UCSD-E4E/Wolf-Tracker/Final V4/Final V4/Step 9.JPG

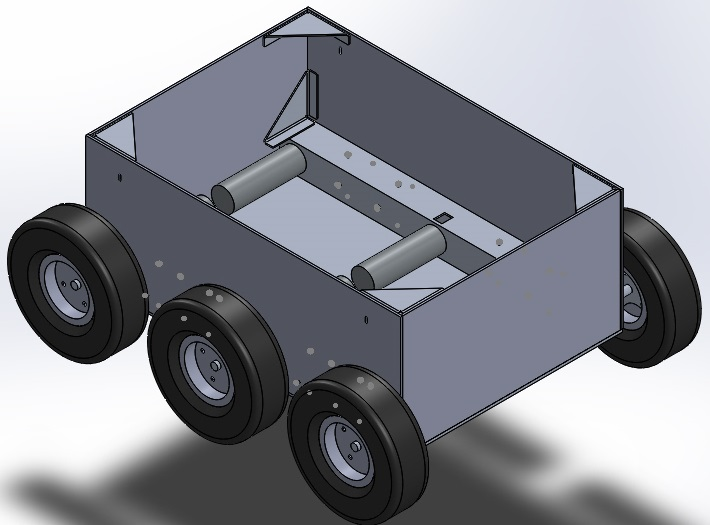
Final V4/Final V4/Step 9.JPG
