UCSD-E4E/Wolf-Tracker/Final V4/Final V4/Rover Documentation.docx

Engineers for Exploration

Terrestrial Vehicle

2013-2014

Rover Assembly Instructions

Legend/Reference Page

Picture | Description/Name

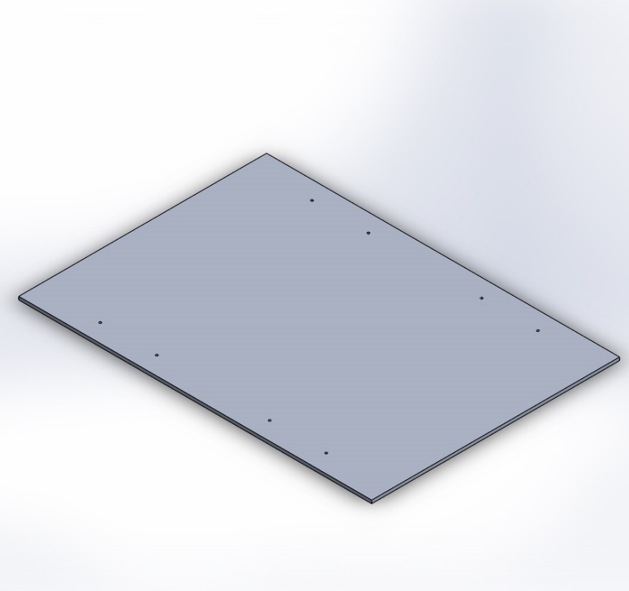
[picture p3: figure]

| Base Plate

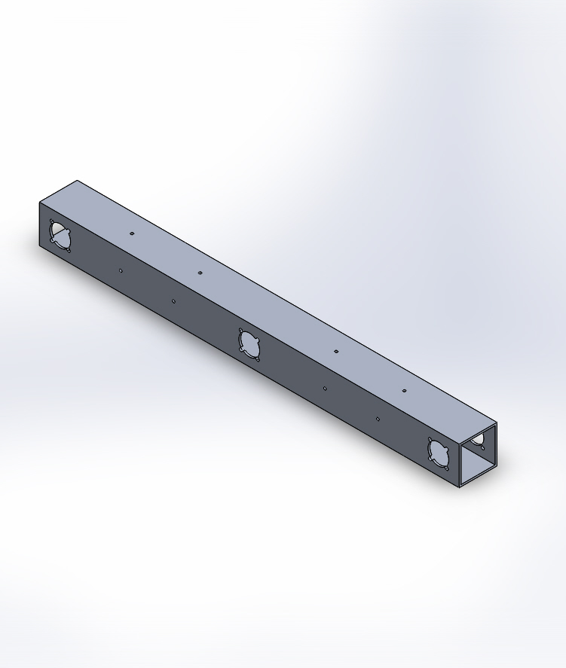
[picture p4: figure]

| Aluminum Bar

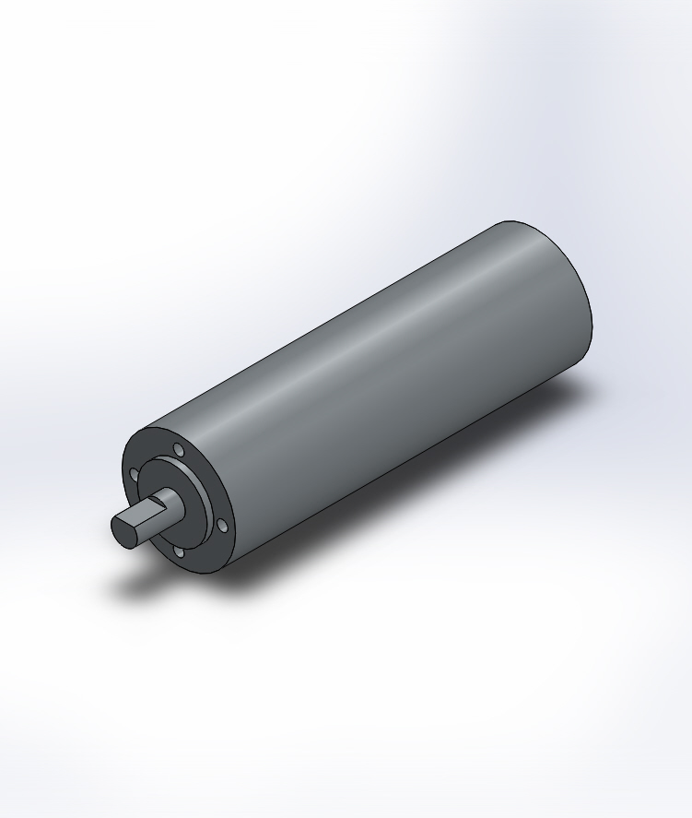
[picture p5: figure]

| Motors

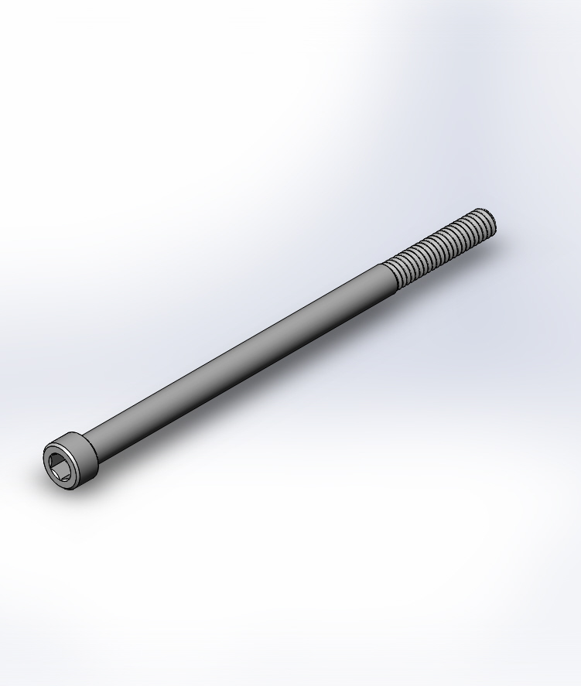
[picture p6: figure]

| 8-32 3.0” Long Screw

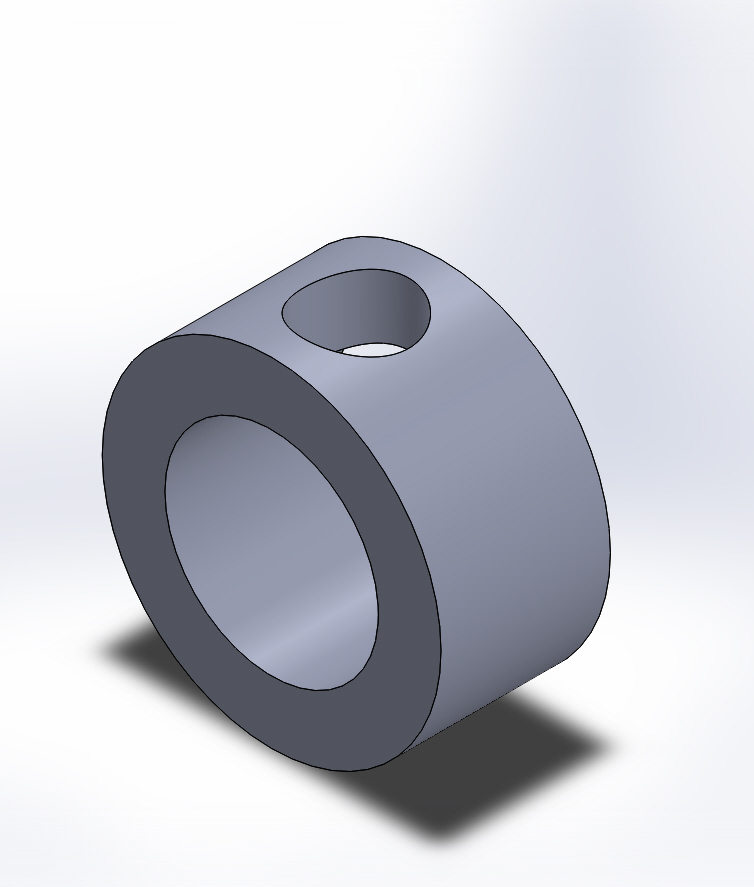
[picture p7: figure]

| Shaft Collar

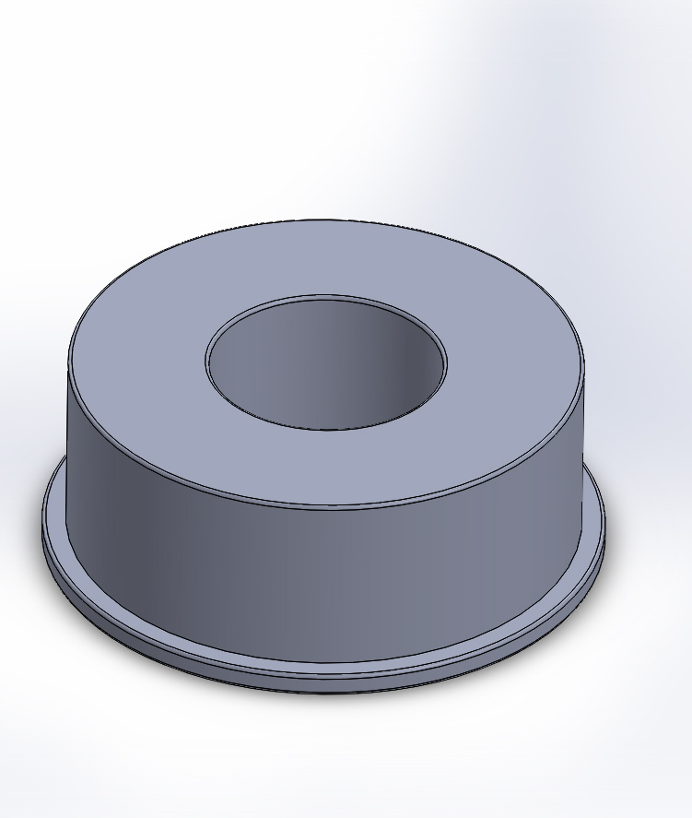
[picture p8: figure]

| Flanged Bearing

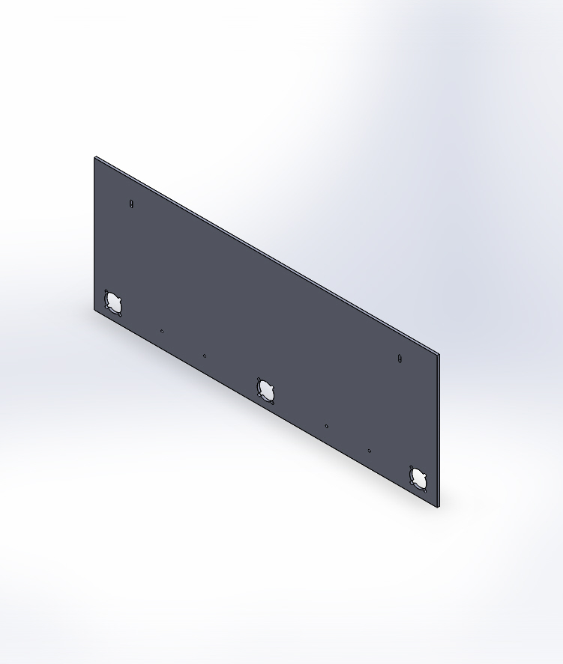
[picture p9: figure]

| Left/Right Side Plate

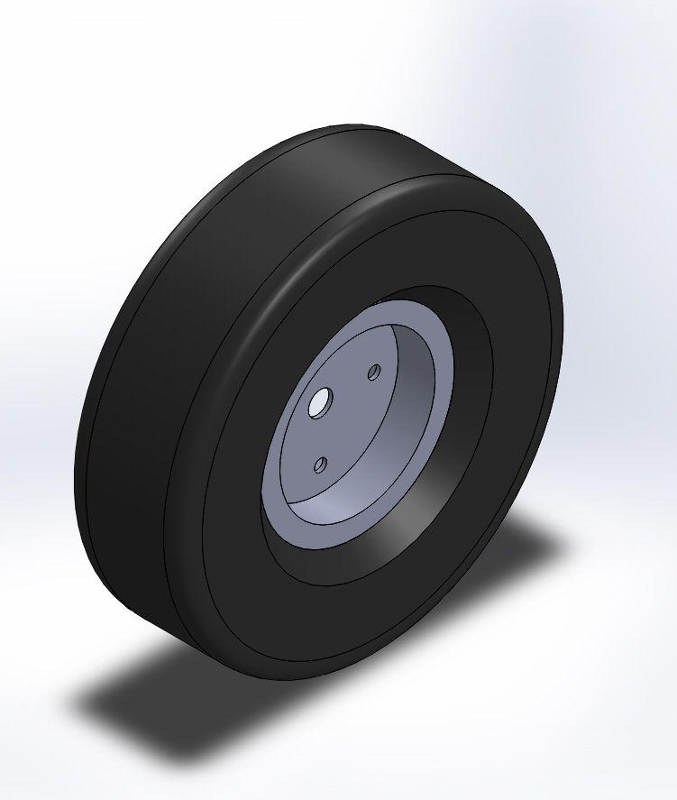
[picture p10: figure]

| Wheel

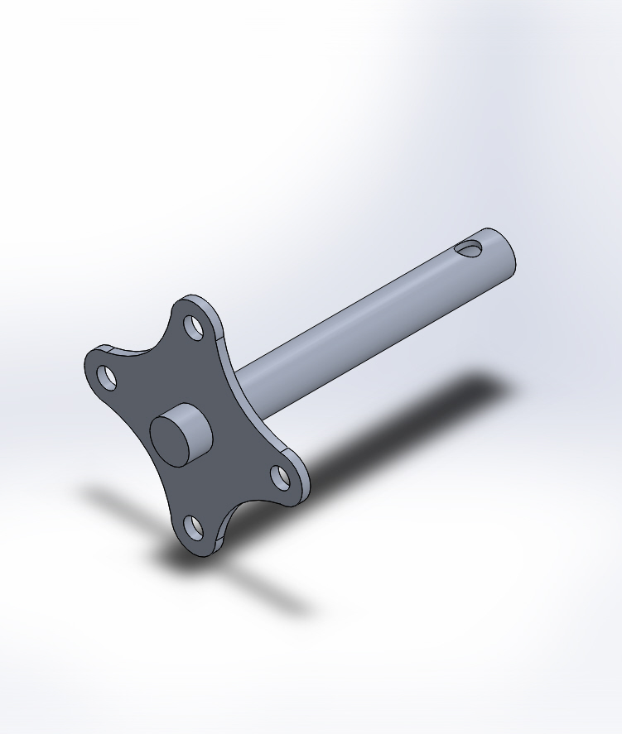
[picture p11: figure]

| Wheel Hub

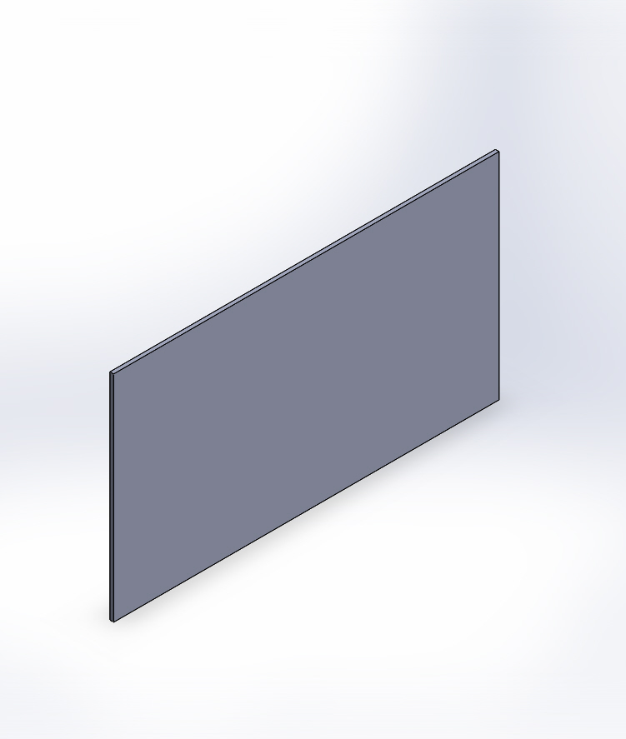
[picture p12: figure]

| Front/Back plate

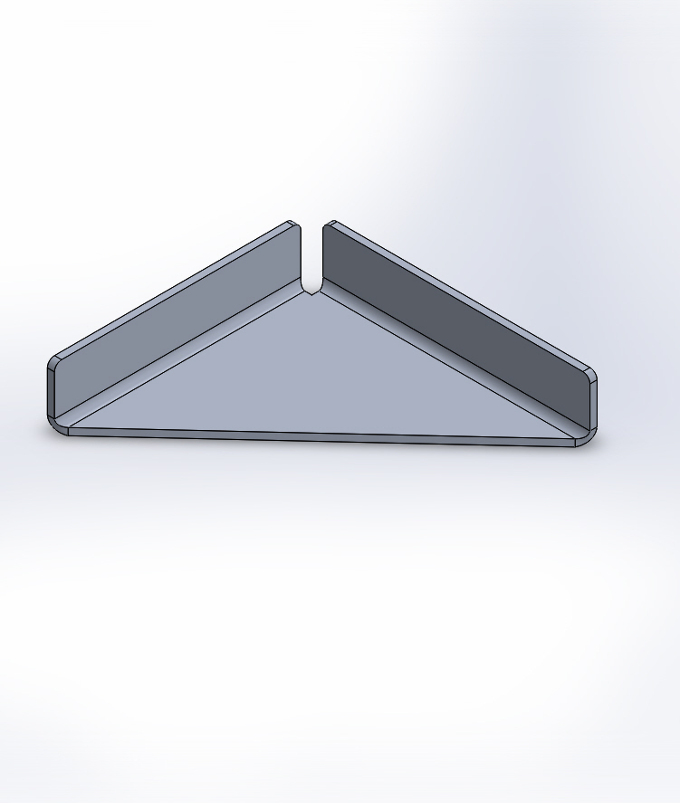
[picture p13: figure]

| Inside corner bracket

Foreword:

This instruction manual will only cover the assembly of the main chassis, excluding the gimbal, gimbal platform, and electronics contained within the rover. Specifically, it will go over the construction of the drive train and body. Note that the order in which the steps are given is important as constructing the body out of order will lead to much difficulty and inefficiency. In reality, parts such as corner brackets and bearings will be marked to go into certain positions are, while interchangeable, best-fitted in their designated positions.

1. Begin by creating the wheel assembly. Using the packaged nuts and bolts, securely attach the wheel hubs to the wheel. Do this for all six wheels.

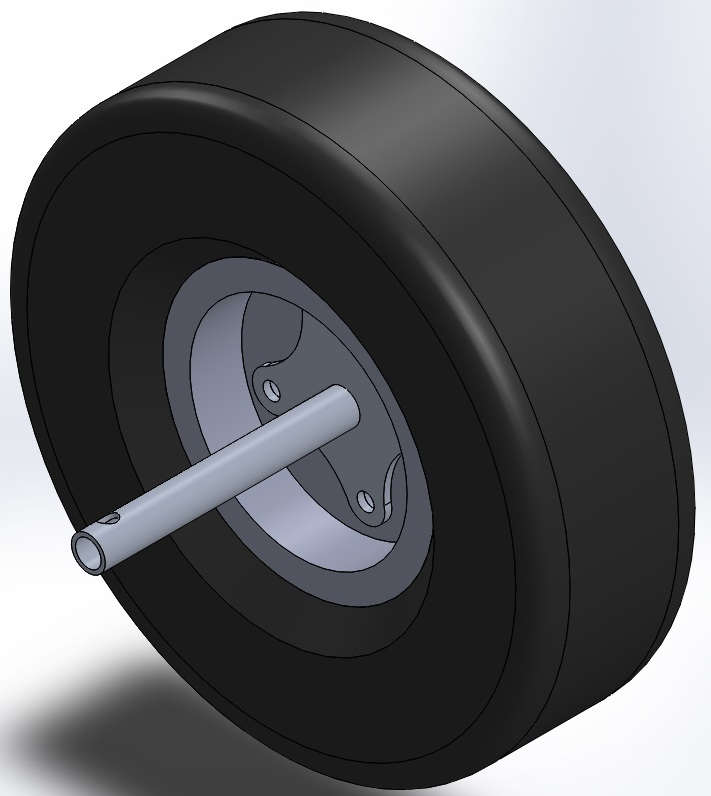
[picture p14: figure]

2. Using the 8-32 long screws, washers, and 8-32 nuts, attach the aluminum bars to the base plate. Take care to observe the proper orientation of the aluminum bars in order to properly affix the motors in the next step.

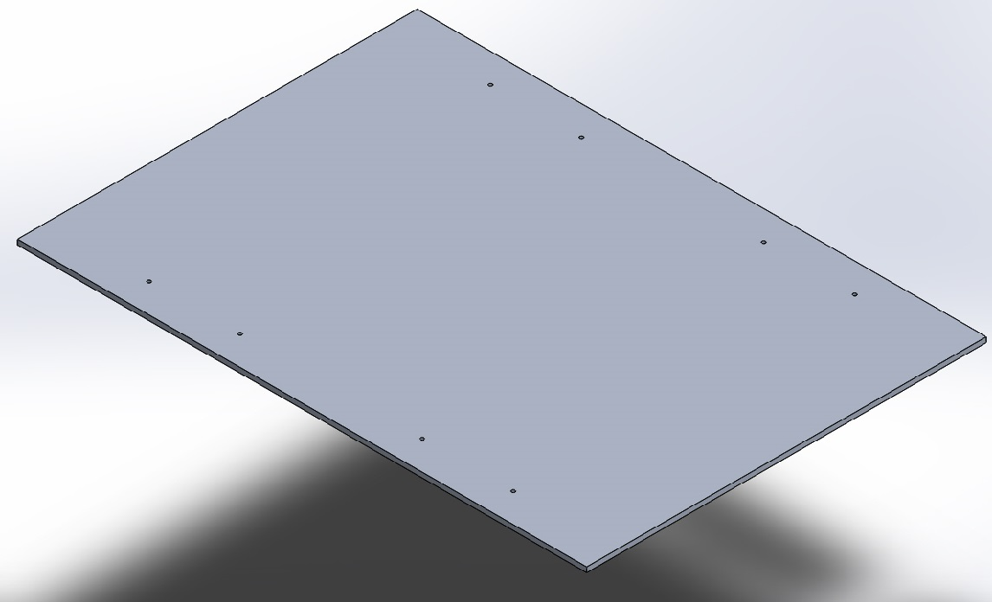
[picture p15: figure]
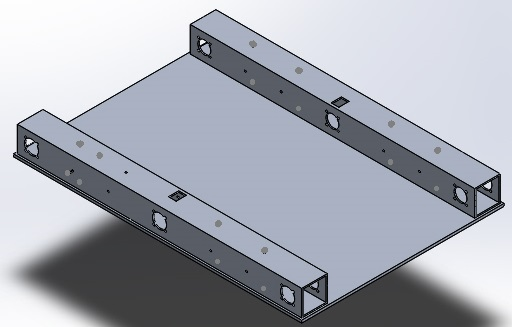
[picture p16: figure]

3. Using the provided motor screws, set each motor into the aluminum bar and screw them in through the radial pattern of clearance holes. If difficulty is found getting all the screws to fit in, it is advisable to loosely screw them all in first, and then tighten as the holes were not milled perfectly according to the CAD.

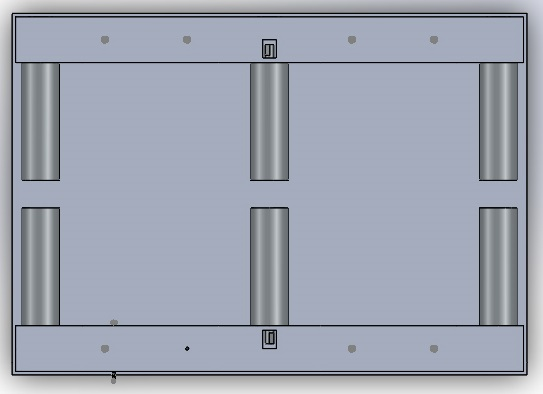
[picture p17: figure]
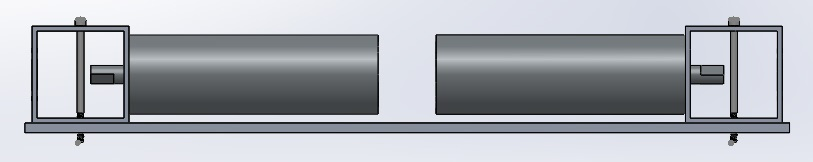
[picture p18: figure]

4. Slip the shaft collar around the motor axle and leave it there for now. The outermost shaft collars can be left until later, but the middle shaft collars are crucial for the installation of the wheels.

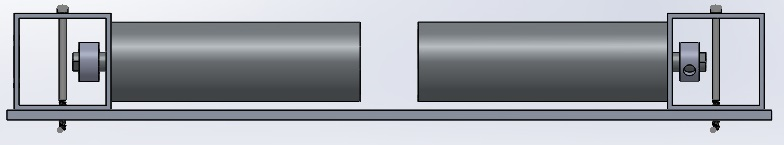
[picture p19: figure]

5. Install the flanged bearings into the aluminum bar, taking care to observe the labels on each bearing. (Example: R3 means it belongs on the right-sided aluminum bar in the third spot from the marked front.)

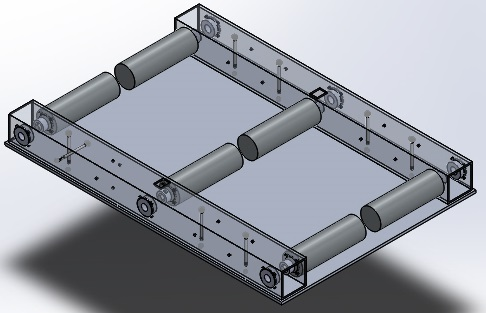
[picture p20: figure]
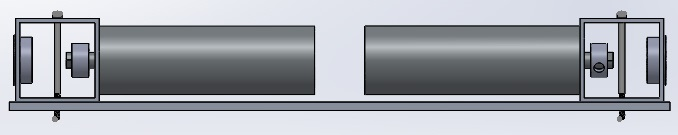
[picture p21: figure]

6. Attach the left and right side plates using the 8-32 long screws, nuts, and washers. Note: Use two washers for each screw between the left and right side plates and the aluminum bar so that, when the screws are tightened, the plates do not warp. (Washers not included)

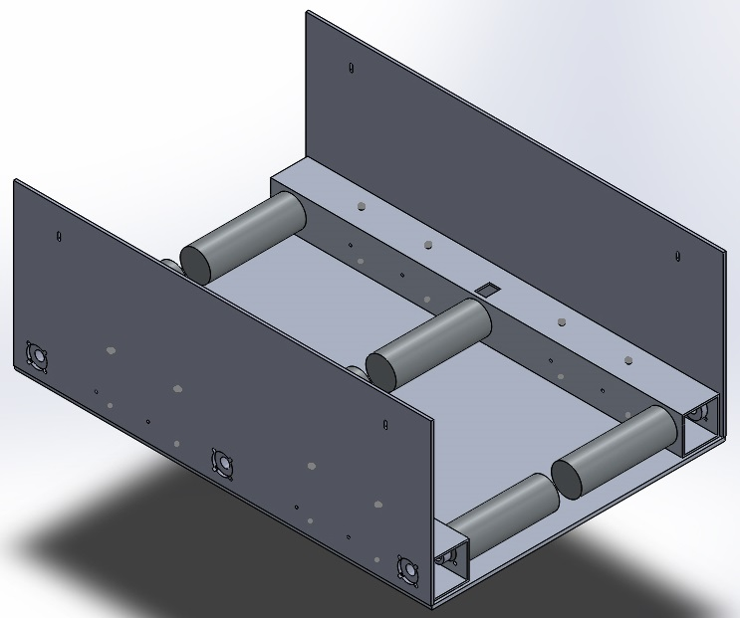
[picture p22: figure]
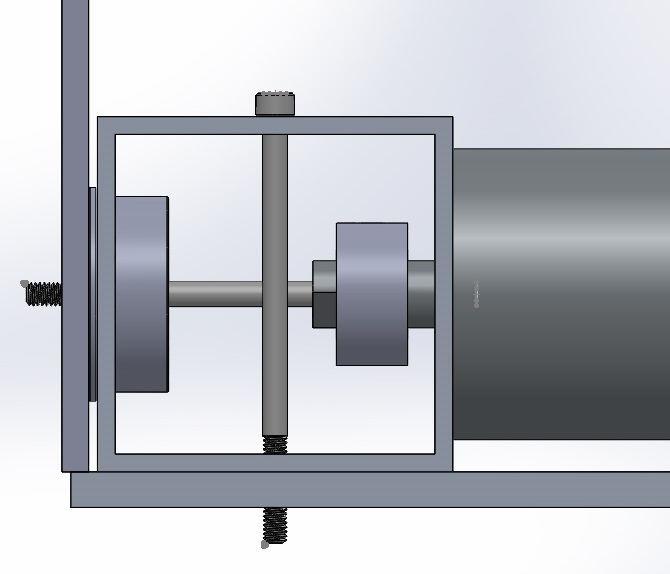
[picture p23: figure]

7. It is advisable to install the middle wheels first, as these are the most difficult. Slip the wheel hub axle through the bearing and onto the motor. Take care also to slip the shaft collar onto the wheel hub axle while aligning the set screw with the hole on the axle and the flat portion of the motor axle.

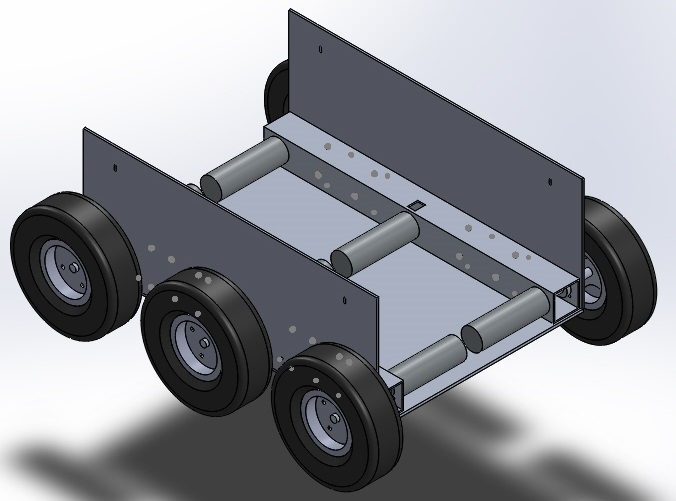
[picture p24: figure]
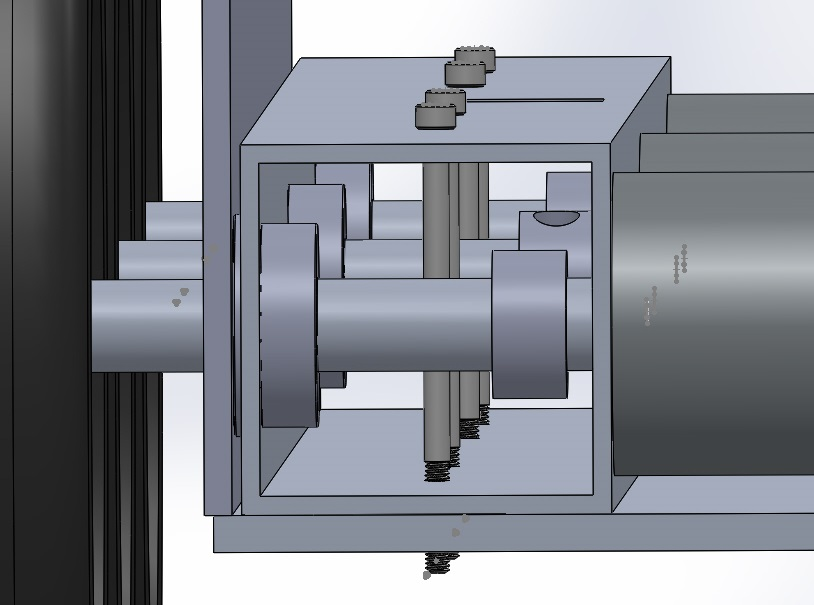
[picture p25: figure]

8. Match each inside corner bracket to their designated spot screw them in.

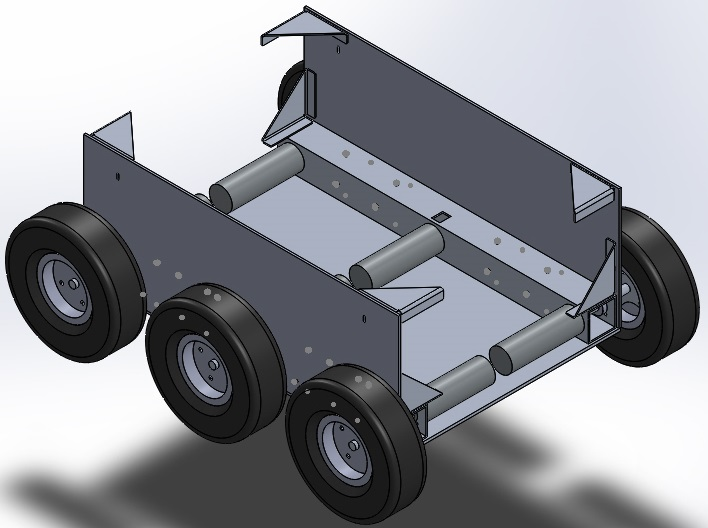
[picture p26: figure]

9. With the brackets in place, install the front and back plates using the corner brackets as a guide.


10. Additional step: Use your own discretion in forming and installing the wheel covers. The large flange can be drilled into and used as a built-in bracket with which to adjoin the cover to the main body.

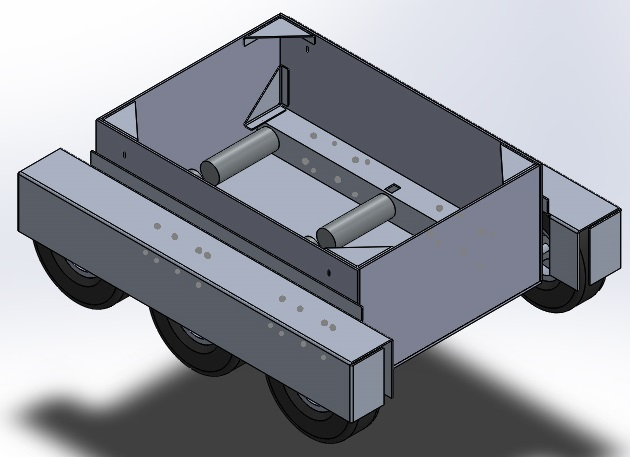
[picture p27: figure]
