UCSD-E4E/Wolf-Tracker/Final V4/Final V4/Base Plate.JPG

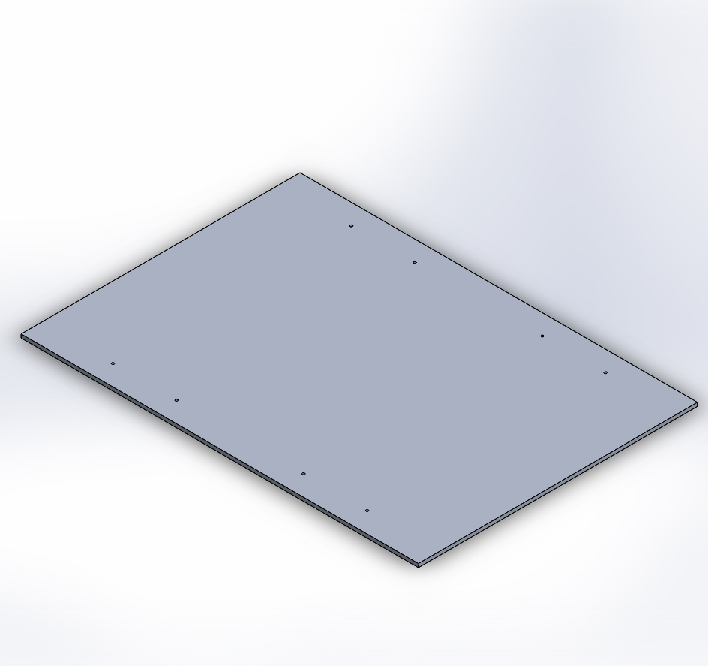
Final V4/Final V4/Base Plate.JPG
