UCSD-E4E/Wolf-Tracker/User Interface/WolfTracker Program/WolfTracker Program/xbox.png

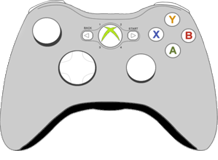
User Interface/WolfTracker Program/WolfTracker Program/xbox.png
