UCSD-E4E/Wolf-Tracker/Final V4/Final V4/Final ATR Drivetrain Assembly V4.SLDASM

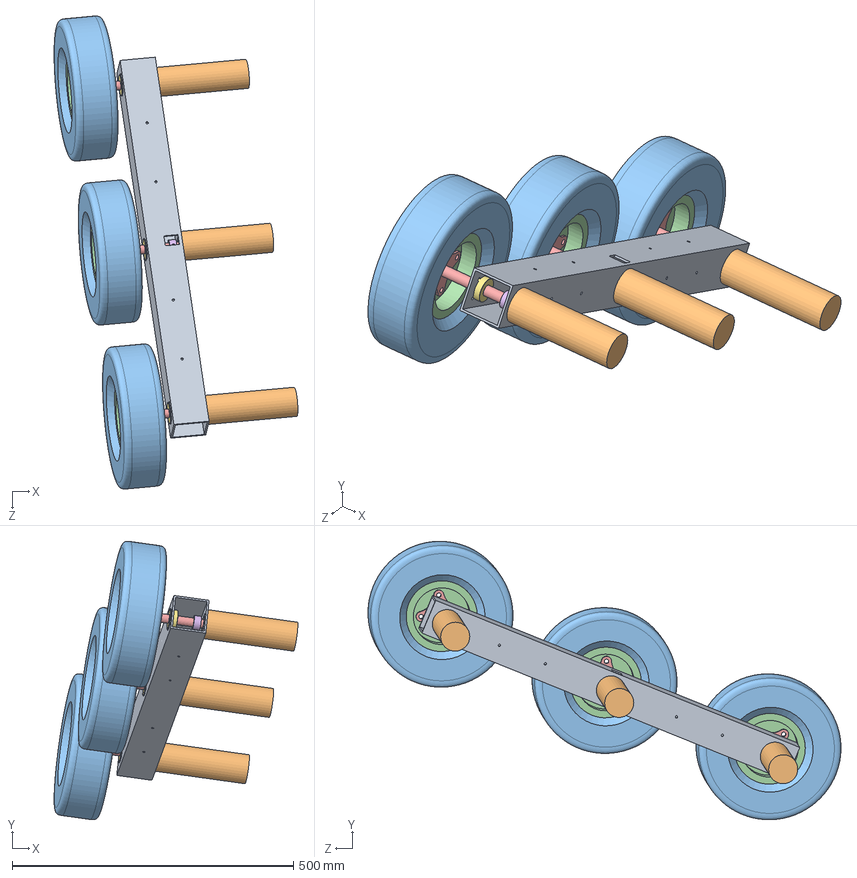
[picture p30: CAD file, 2014-07-06]
Final V4/Final V4/Final ATR Drivetrain Assembly V4.SLDASM
433.6 x 495.0 x 841.2 mm
Final Aluminum Bar V4
Prototype IG52 Motor x 3
Prototype ATR Tire V3 x 3
Prototype ATR Wheel Rim V3 x 3
Prototype ATR Wheel Hub V3 x 3
Final Shaft Collar x 3
Final 0.625'' Bore Sealed Bearing V4 x 3
