UCSD-E4E/Wolf-Tracker/Final V4/Final V4/Final Shelf Assembly V4.SLDASM

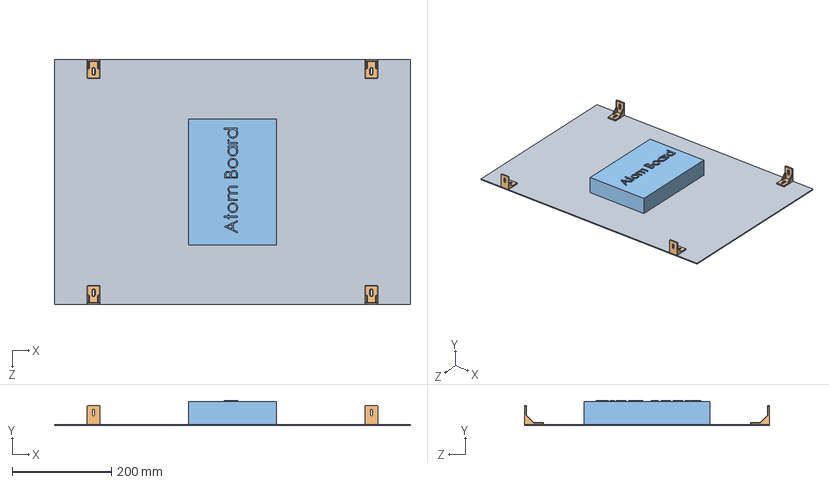
[picture p31: CAD file, 2014-07-06]
Final V4/Final V4/Final Shelf Assembly V4.SLDASM
715.8 x 50.8 x 492.1 mm
Prototype Polycarbonate Shelf V3B
Prototype No 5 Corner Piece V3 x 4
Atom Board
