UCSD-E4E/Wolf-Tracker/Final V4/Final V4/Final Rover Assembly V4.SLDASM

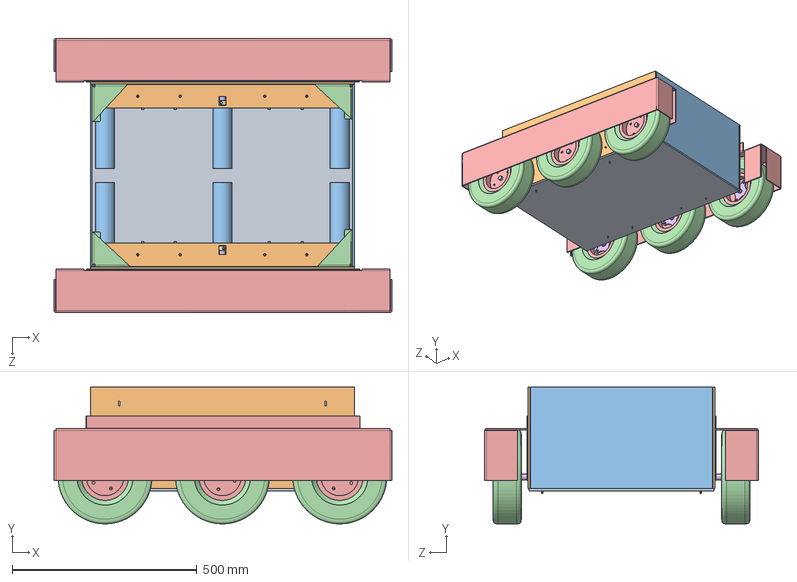
[picture p32: CAD file, 2014-07-06]
Final V4/Final V4/Final Rover Assembly V4.SLDASM
914.4 x 369.9 x 740.4 mm
Final Base-Bottom V4
Final Aluminum Bar V4 x 2
Prototype IG52 Motor x 6
Prototype ATR Tire V3 x 6
Prototype ATR Wheel Rim V3 x 6
Prototype ATR Wheel Hub V3 x 6
Final Shaft Collar x 6
Final 0.625'' Bore Sealed Bearing V4 x 6
8-32 3.0'' Stainless Steel Screw x 16
Final Base-LR V4 x 2
Final Base-FB V4 x 2
Final Inside Corner Bracket x 8
Final Tire Cover V4 x 2
