UCSD-E4E/Wolf-Tracker/Final V4/Final V4/Final 24-12V Converter.SLDPRT

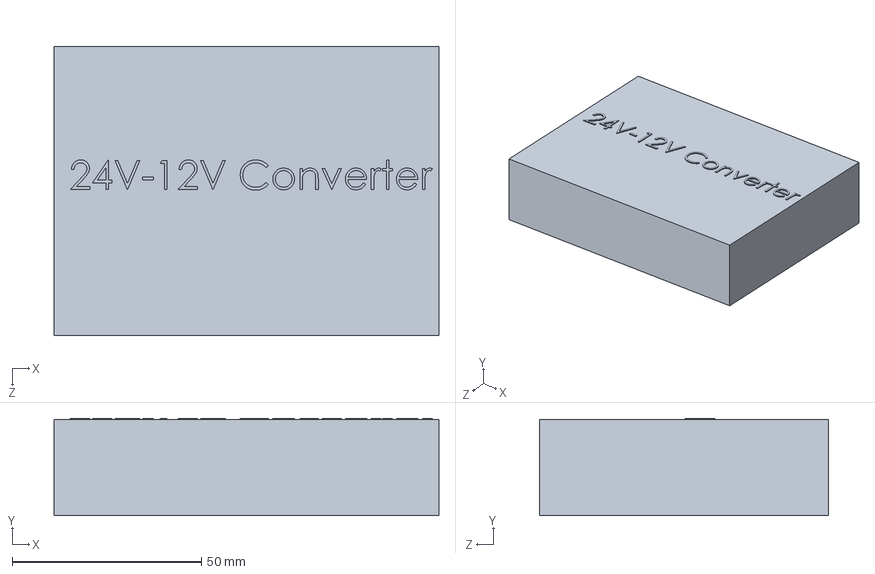
[picture p33: CAD file, 2014-07-06]
Final V4/Final V4/Final 24-12V Converter.SLDPRT
101.6 x 25.7 x 76.2 mm
