UCSD-E4E/Wolf-Tracker/Final V4/Final V4/Mill/Final Aluminum Bar V4.SLDPRT

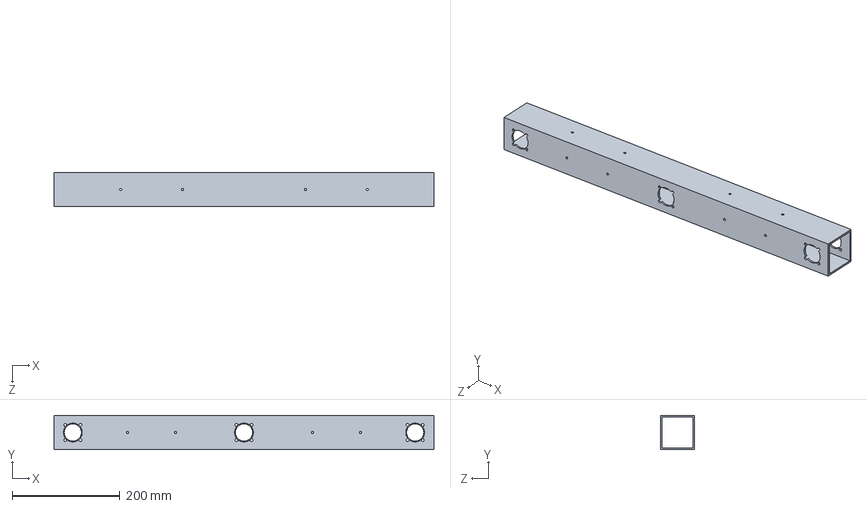
[picture p34: CAD file, 2014-07-06]
Final V4/Final V4/Mill/Final Aluminum Bar V4.SLDPRT
704.9 x 63.5 x 63.5 mm
