UCSD-E4E/Wolf-Tracker/Final V4/Final V4/Prototype ATR Wheel Hub V3.SLDPRT

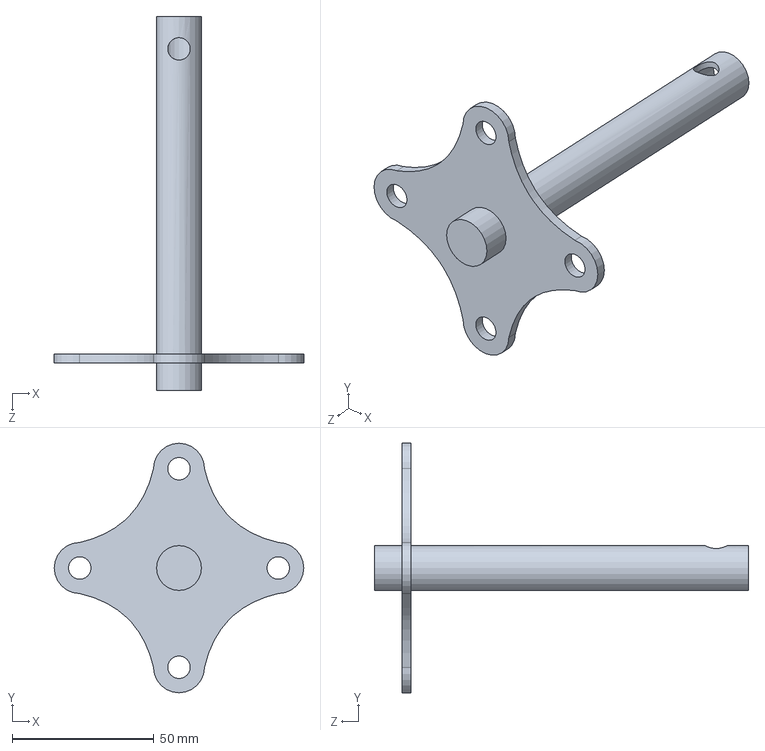
[picture p35: CAD file, 2014-07-06]
Final V4/Final V4/Prototype ATR Wheel Hub V3.SLDPRT
88.1 x 88.1 x 132.1 mm
