UCSD-E4E/Wolf-Tracker/Final V4/Final V4/Final Base-Bottom V4.SLDPRT

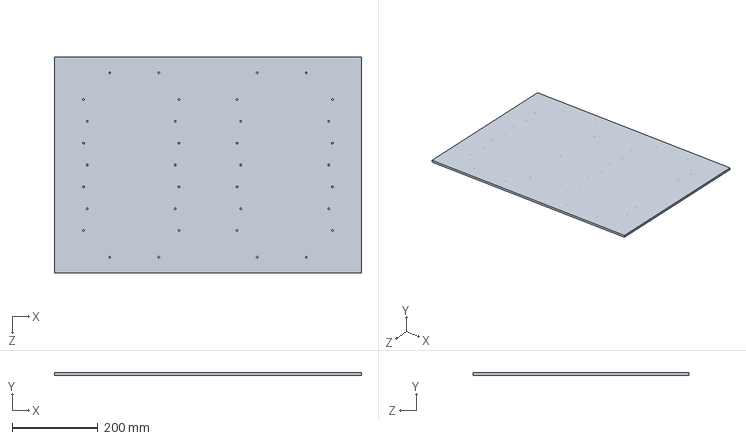
[picture p36: CAD file, 2014-07-06]
Final V4/Final V4/Final Base-Bottom V4.SLDPRT
714.4 x 6.35 x 501.6 mm
