UCSD-E4E/Wolf-Tracker/Final V4/Final V4/Final Inside Corner Bracket.SLDPRT

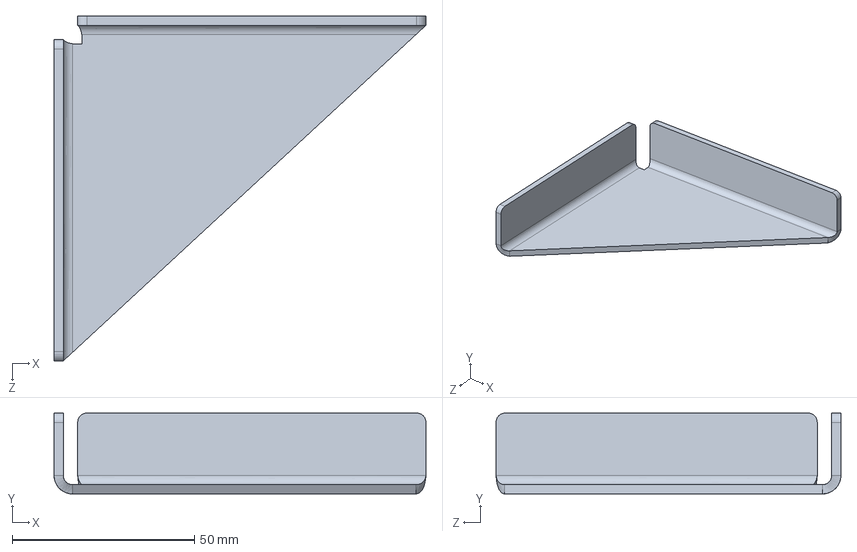
[picture p37: CAD file, 2014-07-06]
Final V4/Final V4/Final Inside Corner Bracket.SLDPRT
102.1 x 22.2 x 94.7 mm
