UCSD-E4E/Wolf-Tracker/Final V4/Final V4/Final Case Top V4.SLDPRT

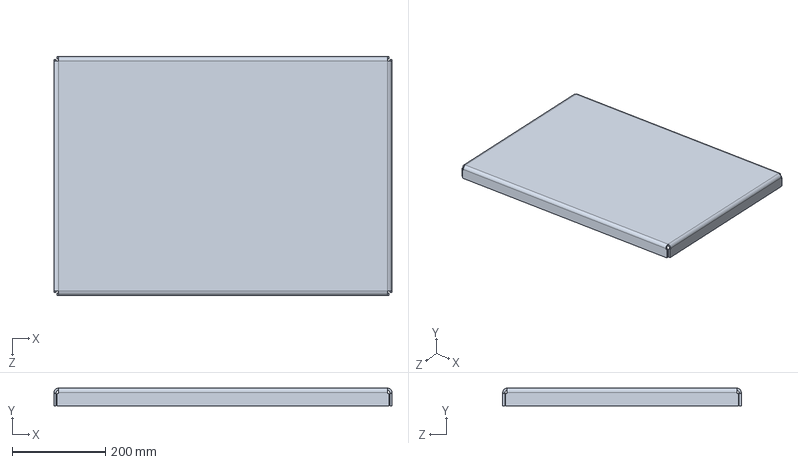
[picture p38: CAD file, 2014-07-06]
Final V4/Final V4/Final Case Top V4.SLDPRT
723.9 x 38.1 x 511.0 mm
