UCSD-E4E/Wolf-Tracker/Final V4/Final V4/Final Base-LR V4.SLDPRT

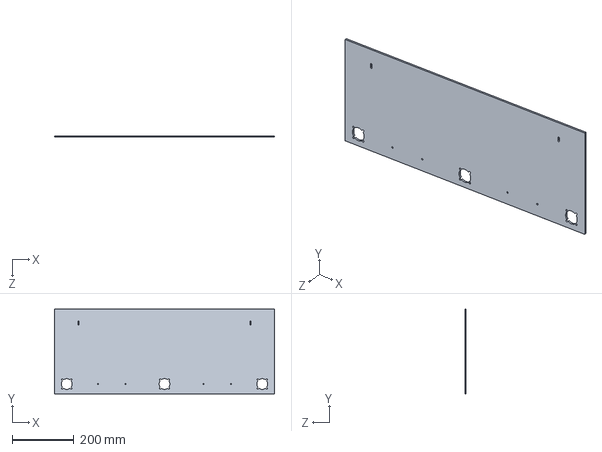
[picture p39: CAD file, 2014-07-06]
Final V4/Final V4/Final Base-LR V4.SLDPRT
714.4 x 274.6 x 4.76 mm
