UCSD-E4E/Wolf-Tracker/Final V4/Final V4/Final 0.625'' Bore Sealed Bearing V4.SLDPRT

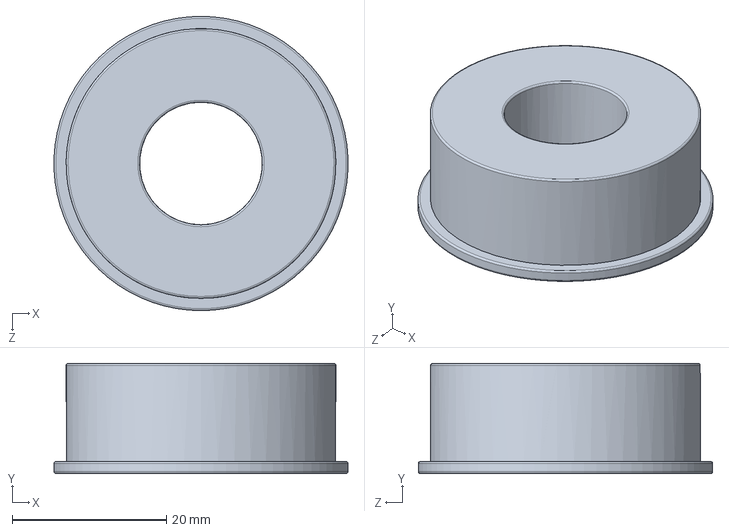
[picture p40: CAD file, 2014-07-06]
Final V4/Final V4/Final 0.625'' Bore Sealed Bearing V4.SLDPRT
38.1 x 14.3 x 38.1 mm
