UCSD-E4E/Wolf-Tracker/Final V4/Final V4/Final Battery Base.SLDPRT

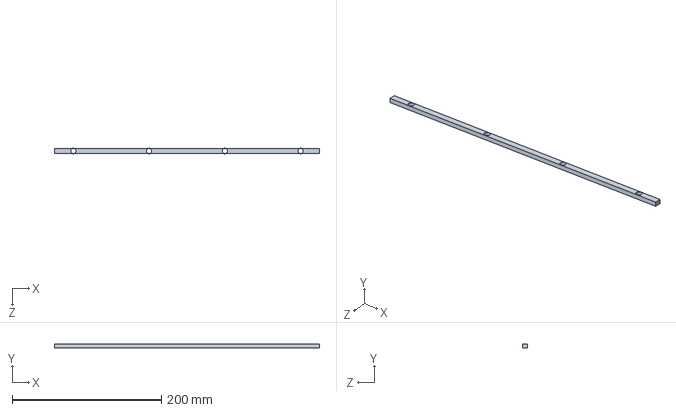
[picture p41: CAD file, 2014-07-06]
Final V4/Final V4/Final Battery Base.SLDPRT
355.6 x 5.08 x 7.30 mm
