UCSD-E4E/Wolf-Tracker/Final V4/Final V4/Final Base-FB V4.SLDPRT

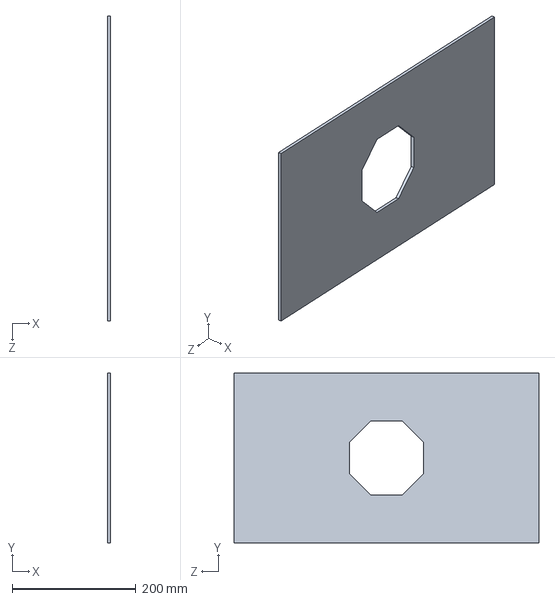
[picture p42: CAD file, 2014-07-06]
Final V4/Final V4/Final Base-FB V4.SLDPRT
4.76 x 274.6 x 492.1 mm
