UCSD-E4E/Wolf-Tracker/Final V4/Final V4/Prototype IG52 Motor.SLDPRT

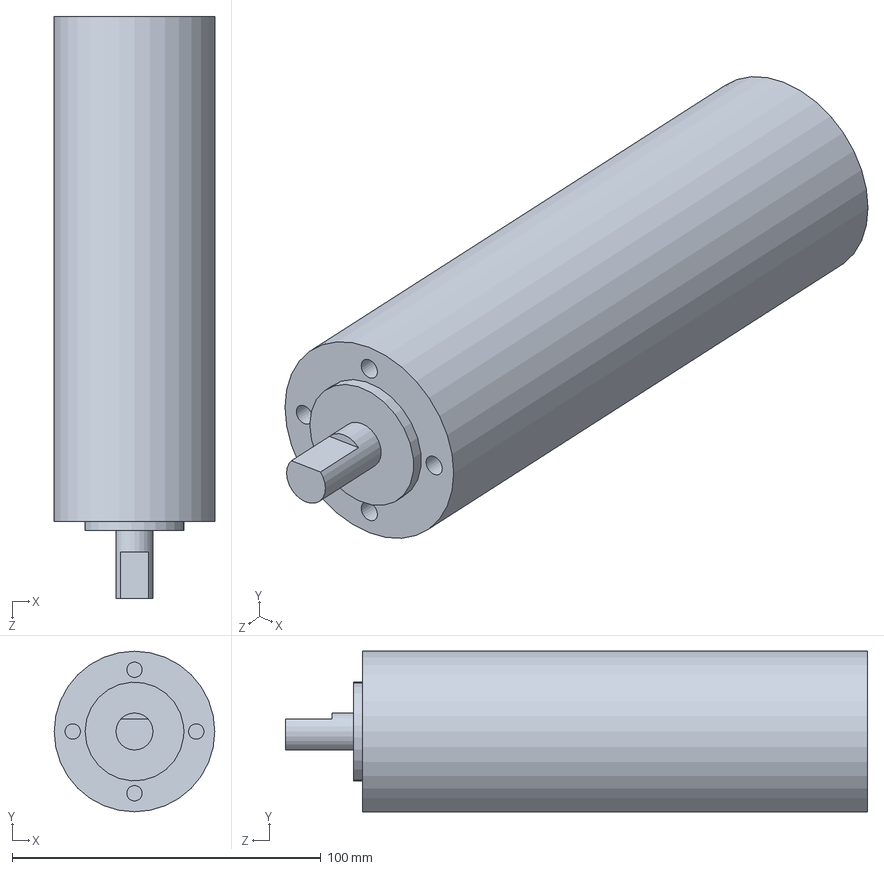
[picture p43: CAD file, 2014-07-06]
Final V4/Final V4/Prototype IG52 Motor.SLDPRT
52.0 x 52.0 x 188.5 mm
