UCSD-E4E/Wolf-Tracker/Final V4/Final V4/Prototype ATR Wheel Rim V3.SLDPRT

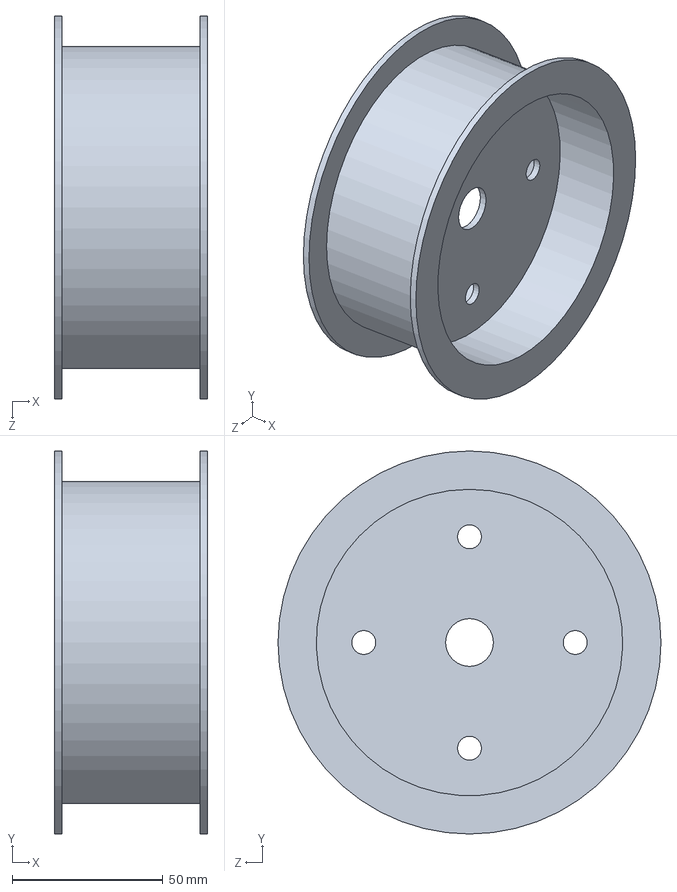
[picture p44: CAD file, 2014-07-06]
Final V4/Final V4/Prototype ATR Wheel Rim V3.SLDPRT
50.8 x 127.0 x 127.0 mm
