UCSD-E4E/Wolf-Tracker/Final V4/Final V4/EZtop Dome.SLDPRT

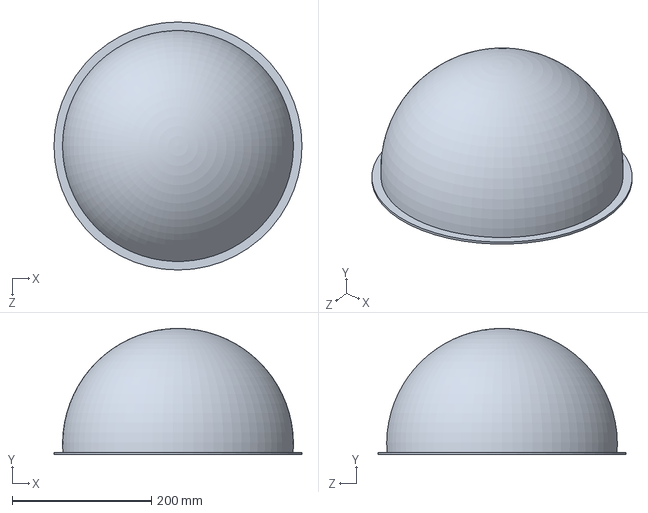
[picture p45: CAD file, 2014-07-06]
Final V4/Final V4/EZtop Dome.SLDPRT
355.6 x 181.0 x 355.6 mm
