UCSD-E4E/Wolf-Tracker/Final V4/Final V4/Final Tire Cover V4B.SLDPRT

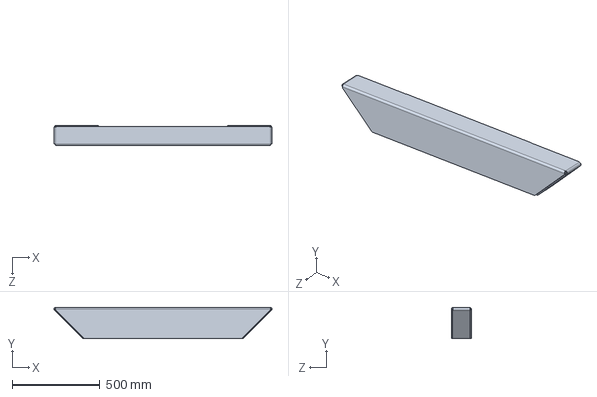
[picture p46: CAD file, 2014-07-06]
Final V4/Final V4/Final Tire Cover V4B.SLDPRT
1243.1 x 177.8 x 114.3 mm
