UCSD-E4E/Wolf-Tracker/Final V4/Final V4/Final Tire Cover V4.SLDPRT

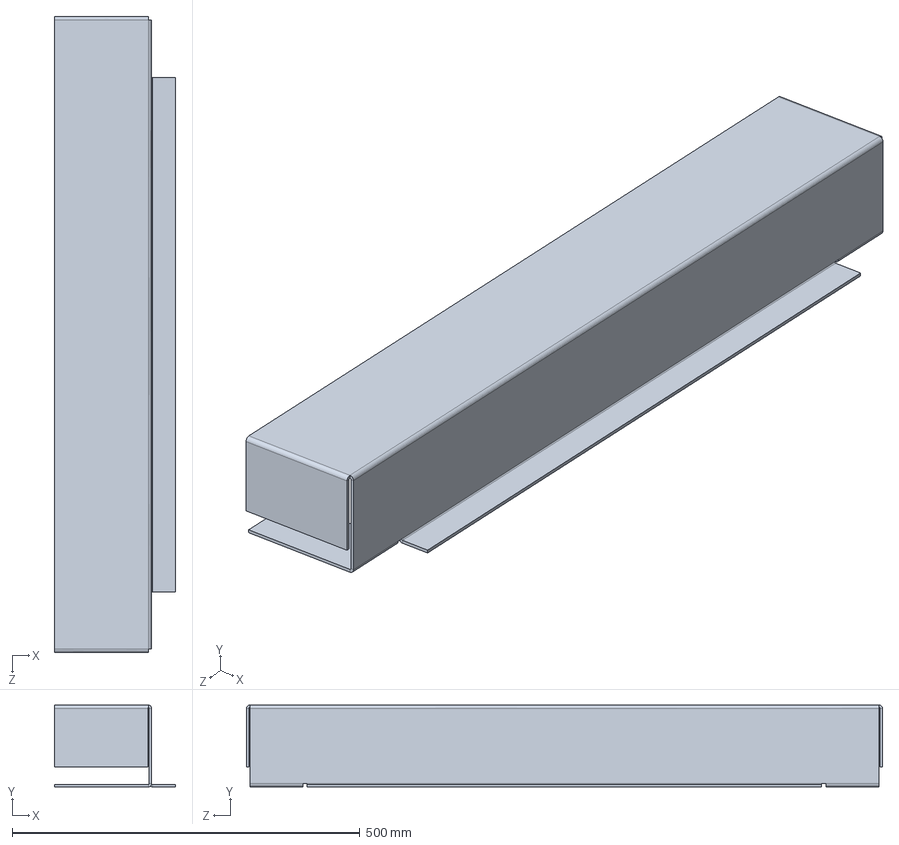
[picture p47: CAD file, 2014-07-06]
Final V4/Final V4/Final Tire Cover V4.SLDPRT
174.6 x 117.8 x 914.4 mm
