UCSD-E4E/Wolf-Tracker/Final V4/Final V4/Final Tire Cover 4C.SLDPRT

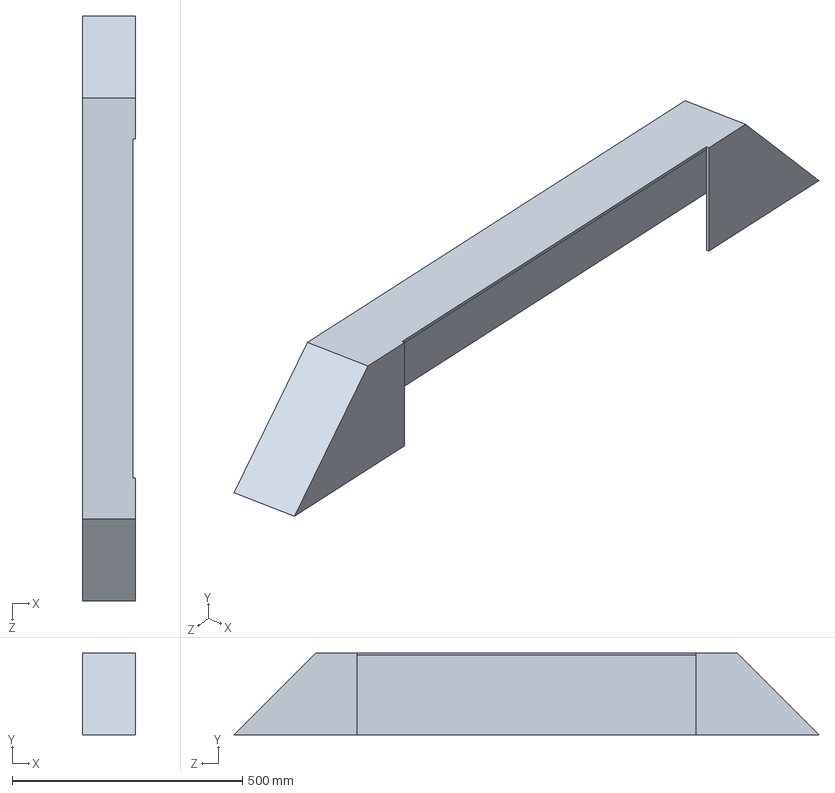
[picture p48: CAD file, 2014-07-06]
Final V4/Final V4/Final Tire Cover 4C.SLDPRT
114.3 x 177.8 x 1270.0 mm
