UCSD-E4E/Wolf-Tracker/Final V4/Final V4/Atom Board.SLDPRT

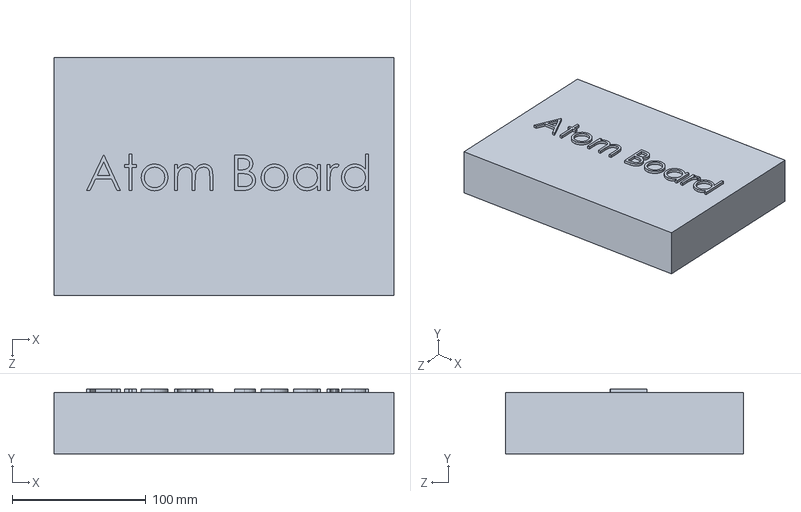
[picture p49: CAD file, 2014-07-06]
Final V4/Final V4/Atom Board.SLDPRT
254.0 x 48.3 x 177.8 mm
