UCSD-E4E/Wolf-Tracker/Final V4/Final V4/Final T Bar.SLDPRT

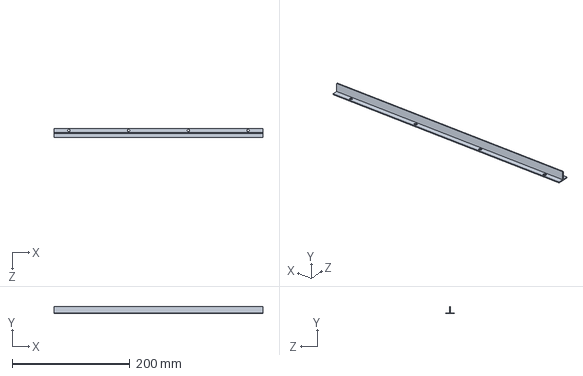
[picture p50: CAD file, 2014-07-06]
Final V4/Final V4/Final T Bar.SLDPRT
355.6 x 12.7 x 15.9 mm
