UCSD-E4E/Wolf-Tracker/Final V4/Final V4/Final Gimbal Protector.SLDPRT

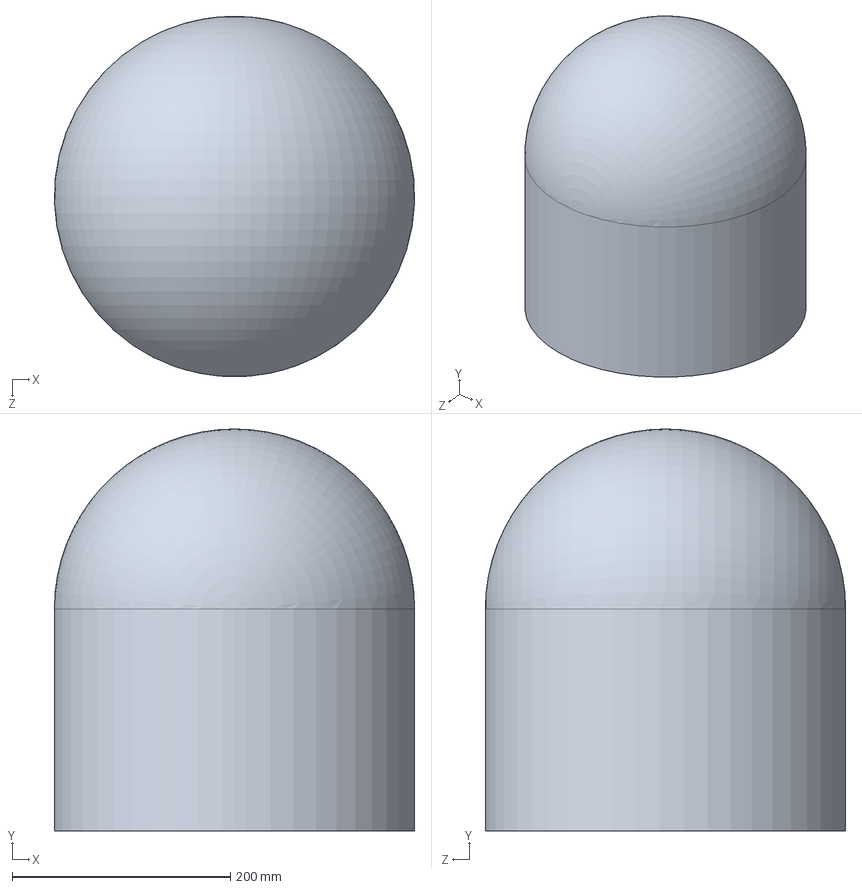
[picture p51: CAD file, 2014-07-06]
Final V4/Final V4/Final Gimbal Protector.SLDPRT
330.0 x 368.3 x 330.2 mm
