UCSD-E4E/Wolf-Tracker/Final V4/Final V4/Final No9 Corner Bracket.SLDPRT

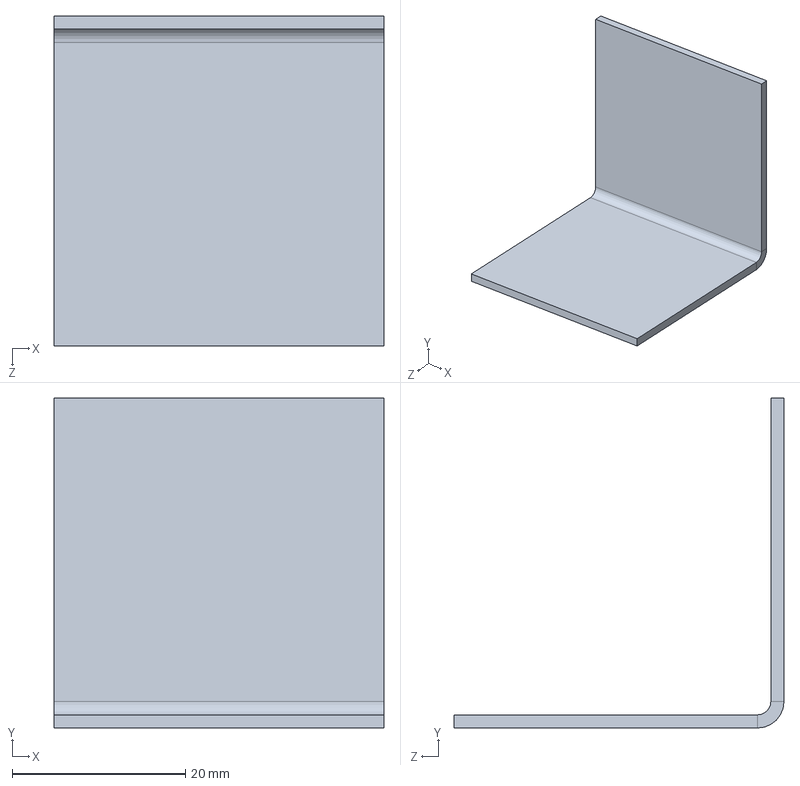
[picture p52: CAD file, 2014-07-06]
Final V4/Final V4/Final No9 Corner Bracket.SLDPRT
38.1 x 38.1 x 38.1 mm
