UCSD-E4E/Wolf-Tracker/Final V4/Final V4/PVC Pipe.SLDPRT

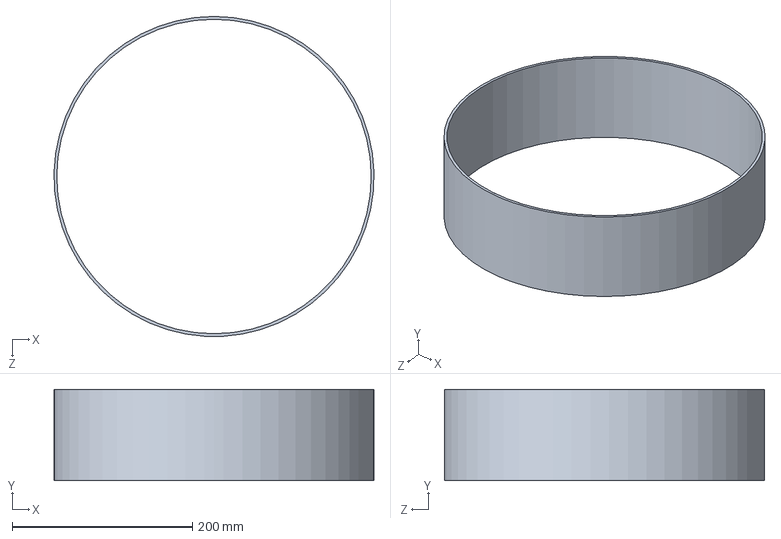
[picture p53: CAD file, 2014-07-06]
Final V4/Final V4/PVC Pipe.SLDPRT
355.4 x 101.6 x 355.6 mm
