UCSD-E4E/Wolf-Tracker/Final V4/Final V4/Final-CivicSolar Battery.SLDPRT

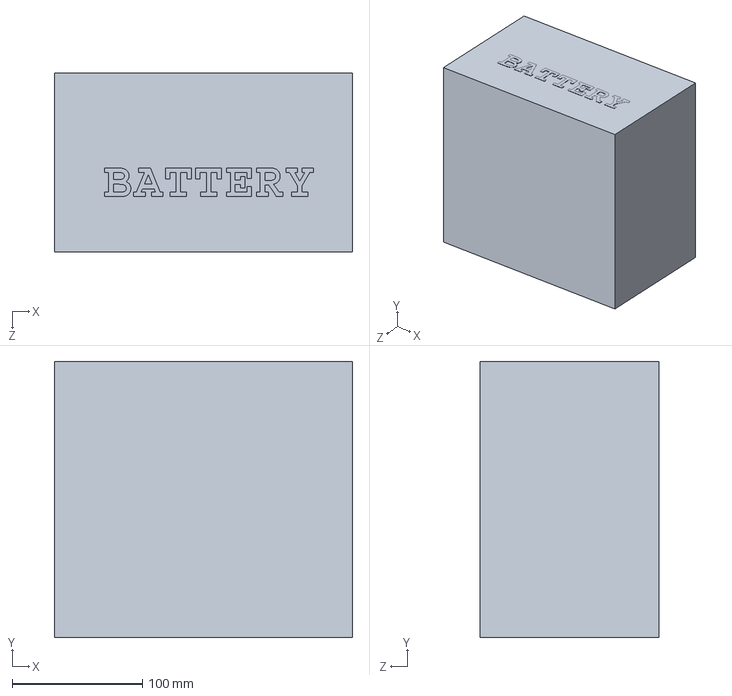
[picture p54: CAD file, 2014-07-06]
Final V4/Final V4/Final-CivicSolar Battery.SLDPRT
229.1 x 212.3 x 137.9 mm
