UCSD-E4E/Wolf-Tracker/Final V4/Final V4/Final 120MM Fan.SLDPRT

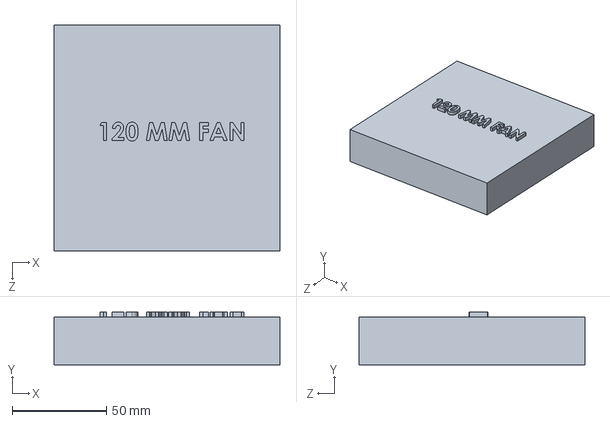
[picture p55: CAD file, 2014-07-06]
Final V4/Final V4/Final 120MM Fan.SLDPRT
120.0 x 27.9 x 120.0 mm
