UCSD-E4E/Wolf-Tracker/Final V4/Final V4/Final Tire Cover V4C.SLDPRT

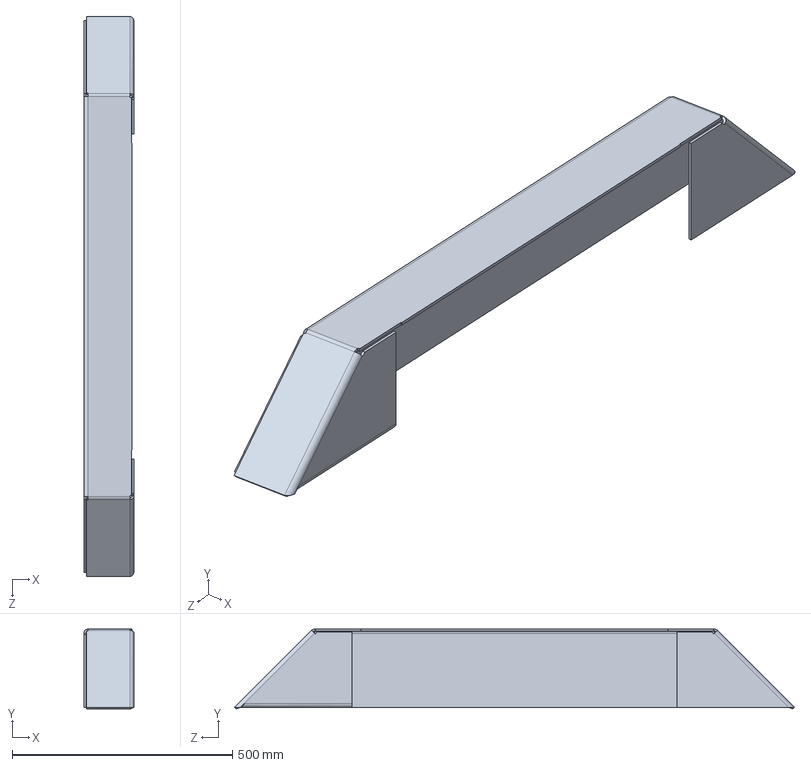
[picture p56: CAD file, 2014-07-06]
Final V4/Final V4/Final Tire Cover V4C.SLDPRT
114.3 x 181.2 x 1270.0 mm
