UCSD-E4E/Wolf-Tracker/Final V4/Final V4/Final Shaft Collar.SLDPRT

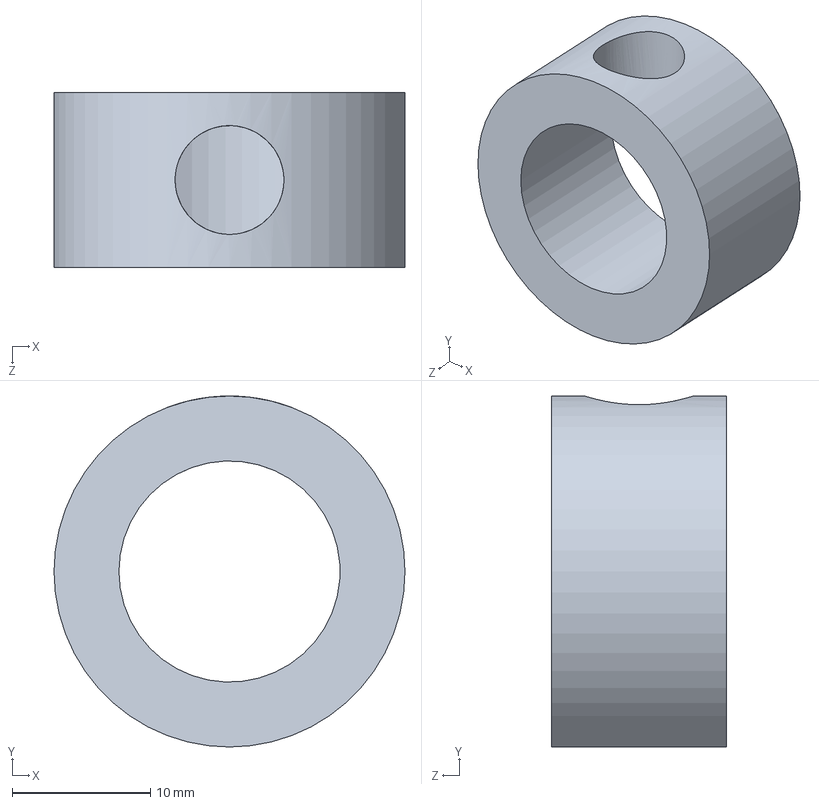
[picture p57: CAD file, 2014-07-06]
Final V4/Final V4/Final Shaft Collar.SLDPRT
25.4 x 25.4 x 12.7 mm
