UCSD-E4E/Wolf-Tracker/Final V4/Final V4/Prototype ATR Tire V3.SLDPRT

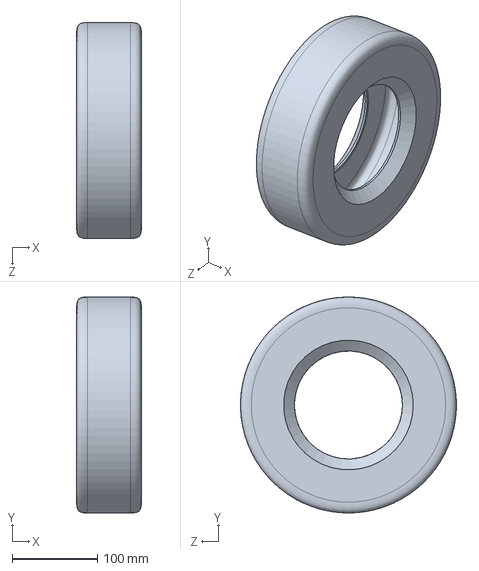
[picture p58: CAD file, 2014-07-06]
Final V4/Final V4/Prototype ATR Tire V3.SLDPRT
76.2 x 254.0 x 253.9 mm
