UCSD-E4E/Wolf-Tracker/Final V4/Final V4/Final F Latch.SLDPRT

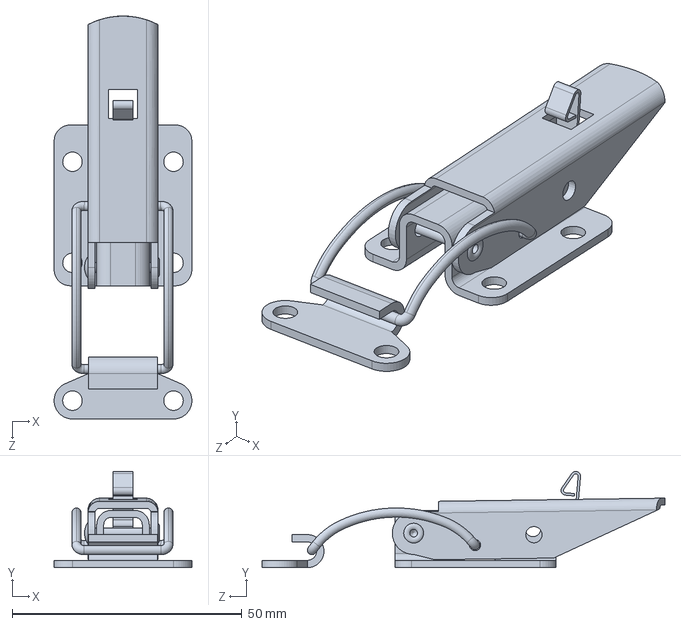
[picture p59: CAD file, 2014-07-06]
Final V4/Final V4/Final F Latch.SLDPRT
30.0 x 21.0 x 87.7 mm
