UCSD-E4E/Wolf-Tracker/Final V4/Final V4/Prototype No 5 Corner Piece V3.SLDPRT

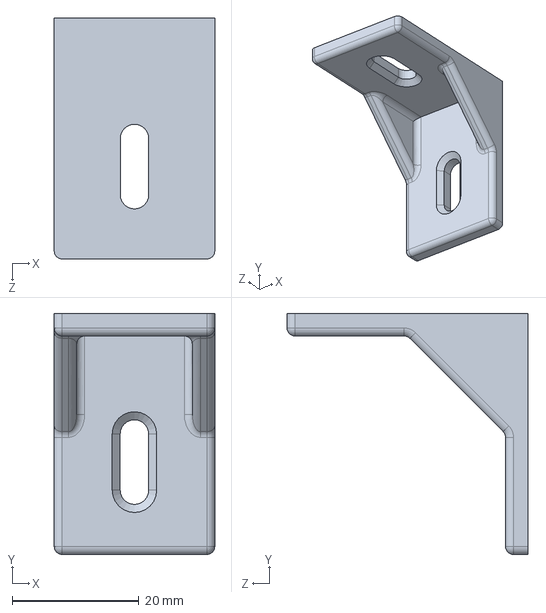
[picture p60: CAD file, 2014-07-06]
Final V4/Final V4/Prototype No 5 Corner Piece V3.SLDPRT
25.4 x 38.1 x 38.1 mm
