UCSD-E4E/Wolf-Tracker/Final V4/Final V4/Prototype Polycarbonate Shelf V3B.SLDPRT

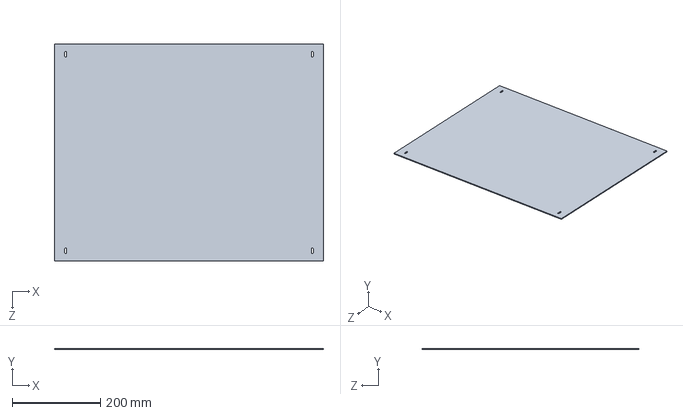
[picture p61: CAD file, 2014-07-06]
Final V4/Final V4/Prototype Polycarbonate Shelf V3B.SLDPRT
609.6 x 2.54 x 492.1 mm
