UCSD-E4E/Wolf-Tracker/Final V4/Final V4/Prototype Gimbal Dome.SLDPRT

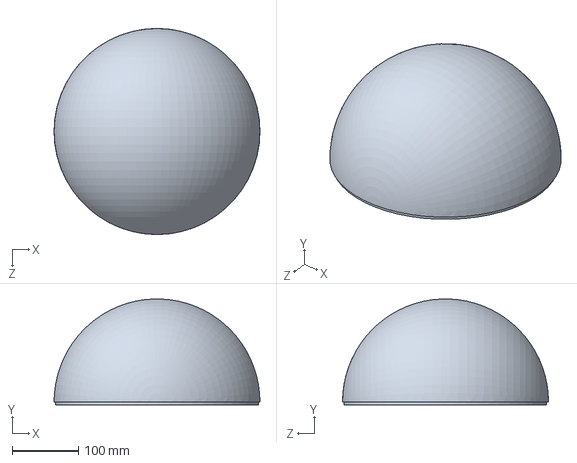
[picture p62: CAD file, 2014-07-06]
Final V4/Final V4/Prototype Gimbal Dome.SLDPRT
309.9 x 159.4 x 309.9 mm
