UCSD-E4E/Wolf-Tracker/(list of files, cad)

Other CAD files:
Final V4/Final V4/6-32 0.5'' Stainless Steel Screw.SLDPRT
Final V4/Final V4/6-32 Stainless Steel Hex Nut.SLDPRT
Final V4/Final V4/6-32 Washer.SLDPRT
Final V4/Final V4/8-32 0.5'' Stainless Steel Screw.SLDPRT
Final V4/Final V4/8-32 3.0'' Stainless Steel Screw.SLDPRT
Final V4/Final V4/8-32 Stainless Steel Hex Nut.SLDPRT
Final V4/Final V4/8-32 Washer.SLDPRT
Final V4/Final V4/Router Table/Final Base-Bottom V4.x_t
Final V4/Final V4/Router Table/Final Base-FB V4.x_t
Final V4/Final V4/Router Table/Final Base-LR V4.x_t
Final V4/Final V4/Router Table/Final Case Top V4.x_t
Final V4/Final V4/Router Table/Final Tire Cover V4B.x_t
