UCSD-E4E/Wolf-Tracker/(commit log)

2014-07-06 Wireless Stream
    Cornell Cup State
2014-07-06 Arduino Code
    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
2014-07-06 SolidWorks Files
    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
    [6-32 0.5'' Stainless Steel Screw.SLDPRT, 6-32 Stainless Steel Hex Nut.SLDPRT, 6-32 Washer.SLDPRT, 8-32 0.5'' Stainless Steel Screw.SLDPRT, 8-32 3.0'' Stainless Steel Screw.SLDPRT, 8-32 Stainless Steel Hex Nut.SLDPRT, 8-32 Washer.SLDPRT, Atom Board.SLDPRT]
